sdavarzani/Haptic-Glove-Data-Acquisition/docs/Haptic_System_Schematic_page-0002.jpg

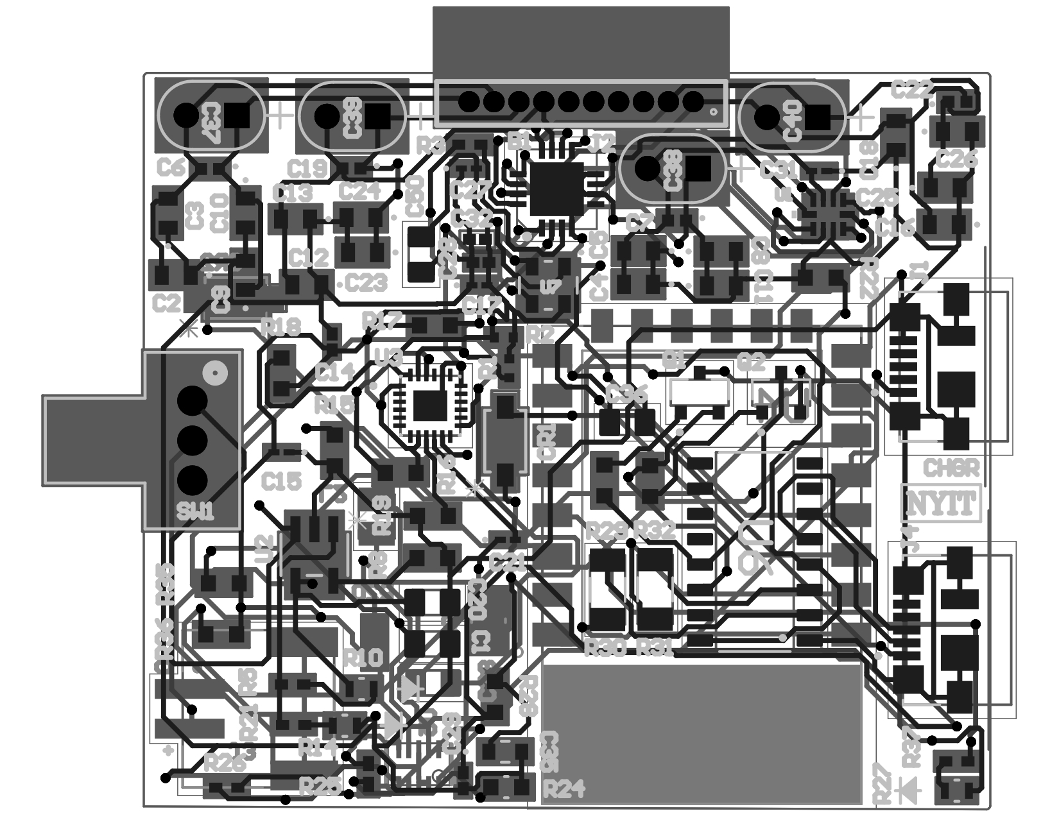
docs/Haptic_System_Schematic_page-0002.jpg
