sdavarzani/Haptic-Glove-Data-Acquisition/bom/BOM_V5.xlsx

Comment | Designator | Footprint | JLCPCB Part
Inductance-to-Digital Converter -4 Ch | B1 | WQFN-16_4x4x0.8P | C2667274
10 µF 10V Ceramic Capacitor 0805 | C1, C20, C33, C36, C50 | 0805_C | C1713
18 pF ±5% 6.3V Ceramic Capacitor | C2, C3, C4, C5, C8, C9, C10, C11, C12, C13, C16, C18, C23, C24, C25, C26 | 0603_C | C389109
33 pF ±10% 10V Ceramic Capacitor | C6, C7, C19, C22 | 0402_C | C2169710
10000 pF ±10% 10V Ceramic Capacitor | C14, C28 | 0402_C | C26569974
0.1 µF ±10% 6.3V Ceramic Capacitor | C15, C17, C21, C27, C31 | 0603_C | C76928
470 pF ±5% 50V Ceramic Capacitor | C29 | 0402_C | C2167469
100 µF ±20% 6.3V Ceramic Capacitor | C30 | 0805_C | C141660
1 µF ±10% 6.3V Ceramic Capacitor | C32 | 0402_C | C2649511
22 µF ±20% 10V Ceramic Capacitor | C35 | 0603_C | C86295
Diode 40 V 1A Surface Mount SOD-123 | CR1, CR2 | SOD-123 | C84354
Micro-USB-B | J1, J4 | MOLEX_47346-0001 | C132560
470 nH Shielded Multilayer Inductor 500 mA | L1 | 0806_L | C668312
(BJT) Transistor NPN 45 V 500 m | Q1, Q2 | SOT-23 | C39828
4.7 kOhms ±5% 0.063W, 1/16W | R1, R2 | 0402_R | C25900
RES 0 OHM JUMPER 1/16W 0402 | R3 | 0402_R | C60485
470 Ohms ±1% 0.063W, 1/16W Chip Resistor | R5, R21, R37 | 0402_R | C114877
RES 10 kOhms ±1% 0.1W, 1/10W | R8, R15, R16, R17, R18, R19, R20, R22, R28, R29, R32, R35, R36 | 0603_R | C98220
RedLED Indication - 2.2V 0603 | R10, R27 | 0603_LED | C2693608
GreenLED Indication 2.2V 0603 | R14 | 0603_LED | C7012325
91 kOhms ±5% 0.1W, 1/10W Resistor | R24 | 0603_R | C137603
511 kOhms ±1% 0.063W, 1/16W Chip Resistor | R25 | 0402_R | C64042
100 kOhms ±5% 0.1W, 1/10W Resistor | R26 | 0402_R | C413017
470 Ohms ±1% 0.25W, 1/4W Resistor 1206 | R30, R31 | 1206_R | C4502
(SPDT), 2-channel ,IC analog switch | U1 | UQFN-10 | C128409
Charger IC Lithium Ion/Polymer SOT-23-5 | U2 | SOT23-5 | C424093
ESP8266 | U4 | ESP-12E | C89297
Regulator IC Positive Adjustable | U5 | VSON-10 | C2845237
USB to serial chip CH340 | U6 | SOP-16 | C84681
40 MHz CMOS Oscillator | U7 | OSC-SMD_2.5x2.0 | C669071
