sdavarzani/Haptic-Glove-Data-Acquisition/docs/Haptic_System_Schematic.pdf

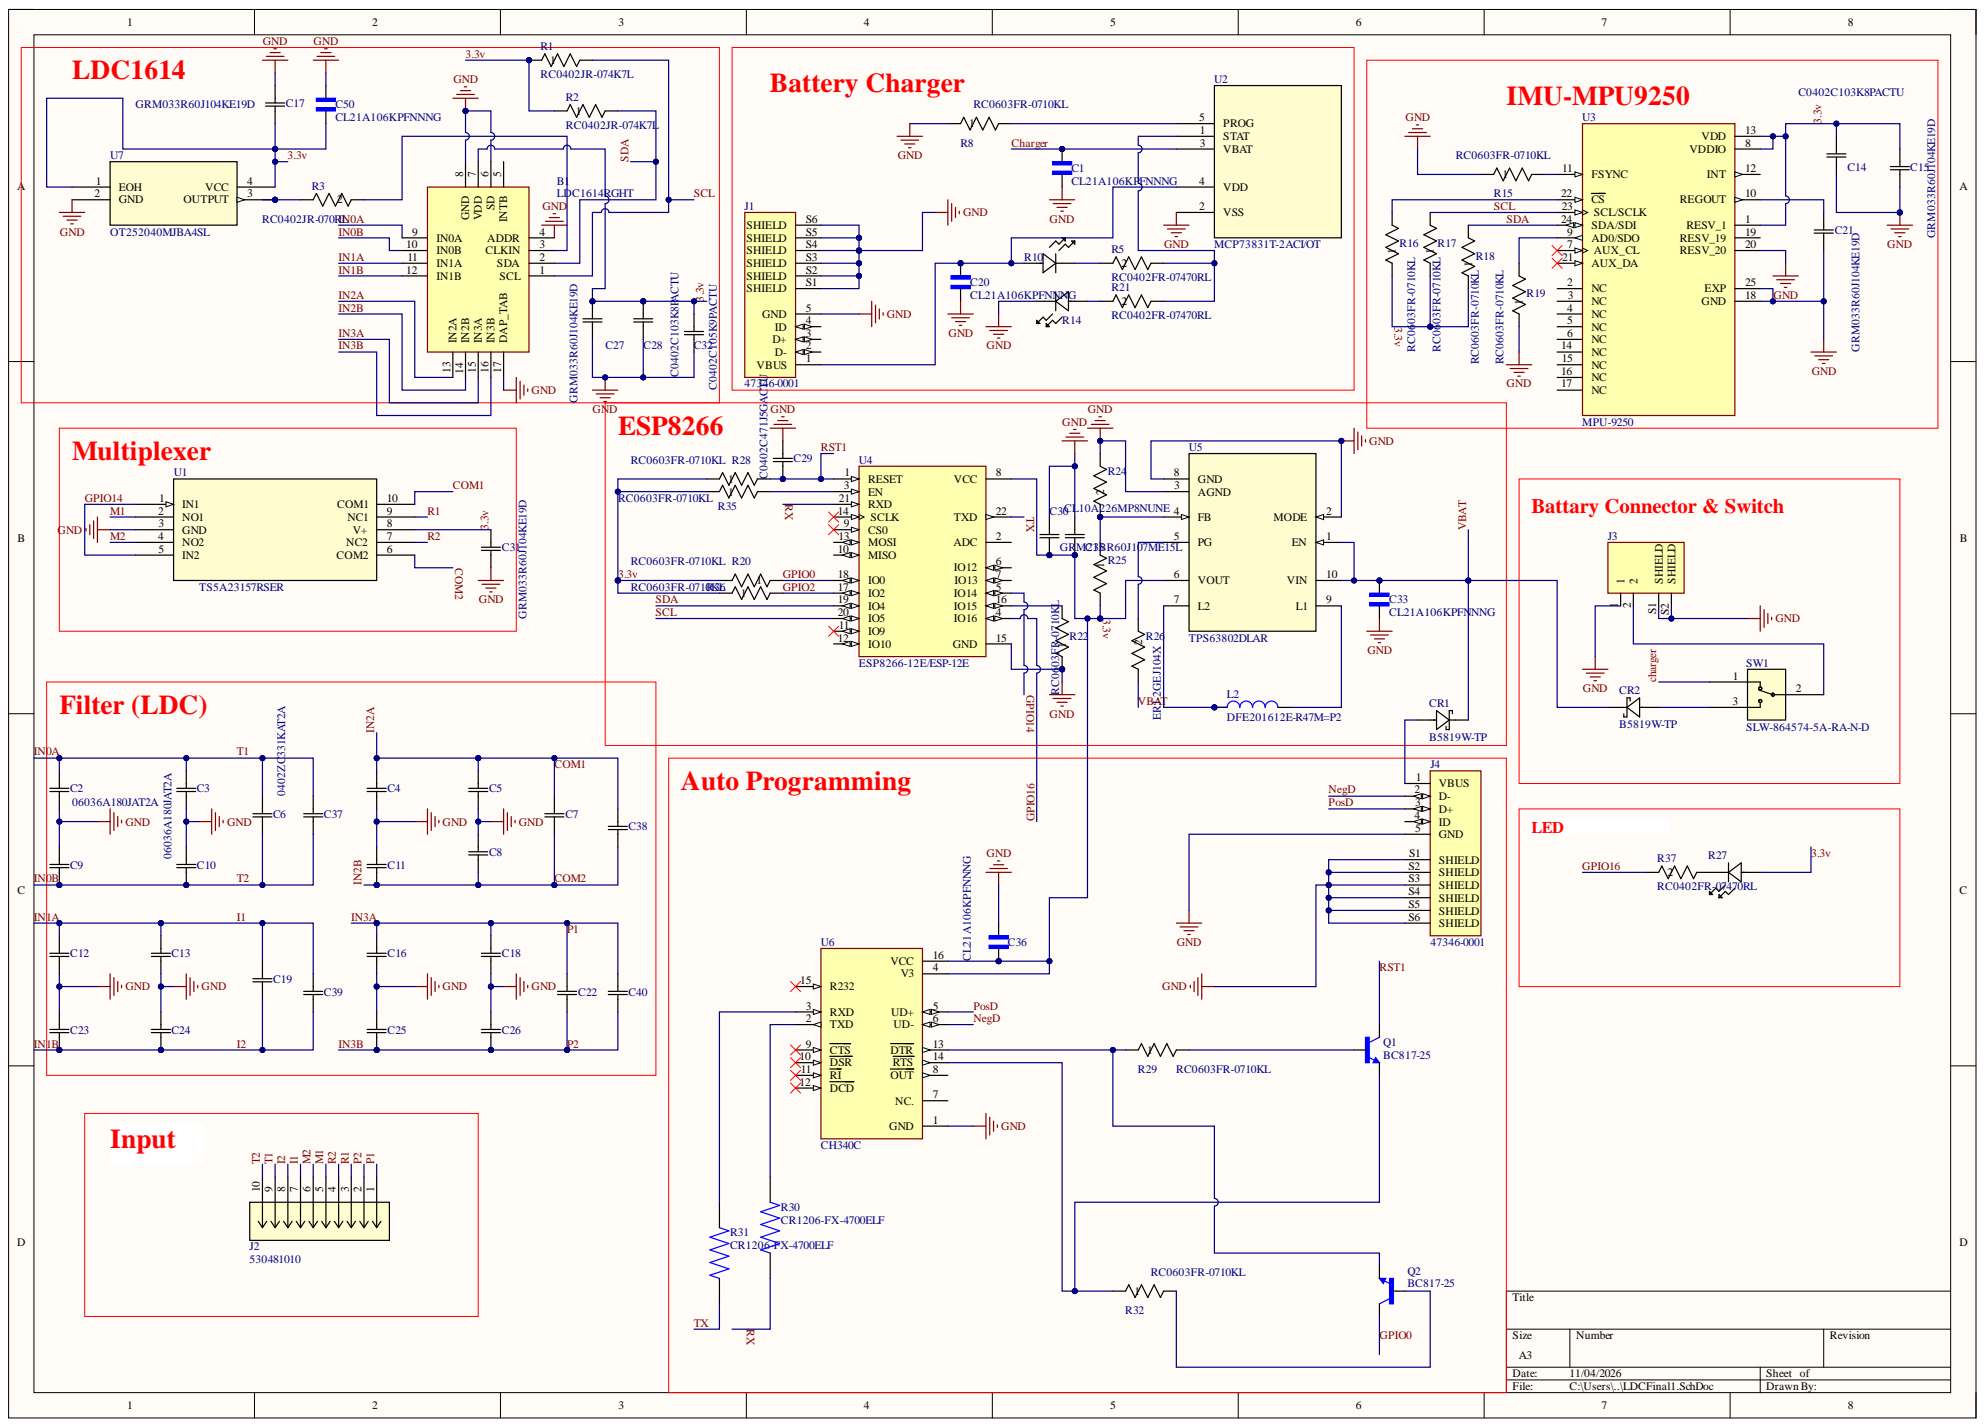
[picture p6: page 1]

INTB 5 SD 6 VDD 7 GND 8

SHIELD S3

SHIELD S5

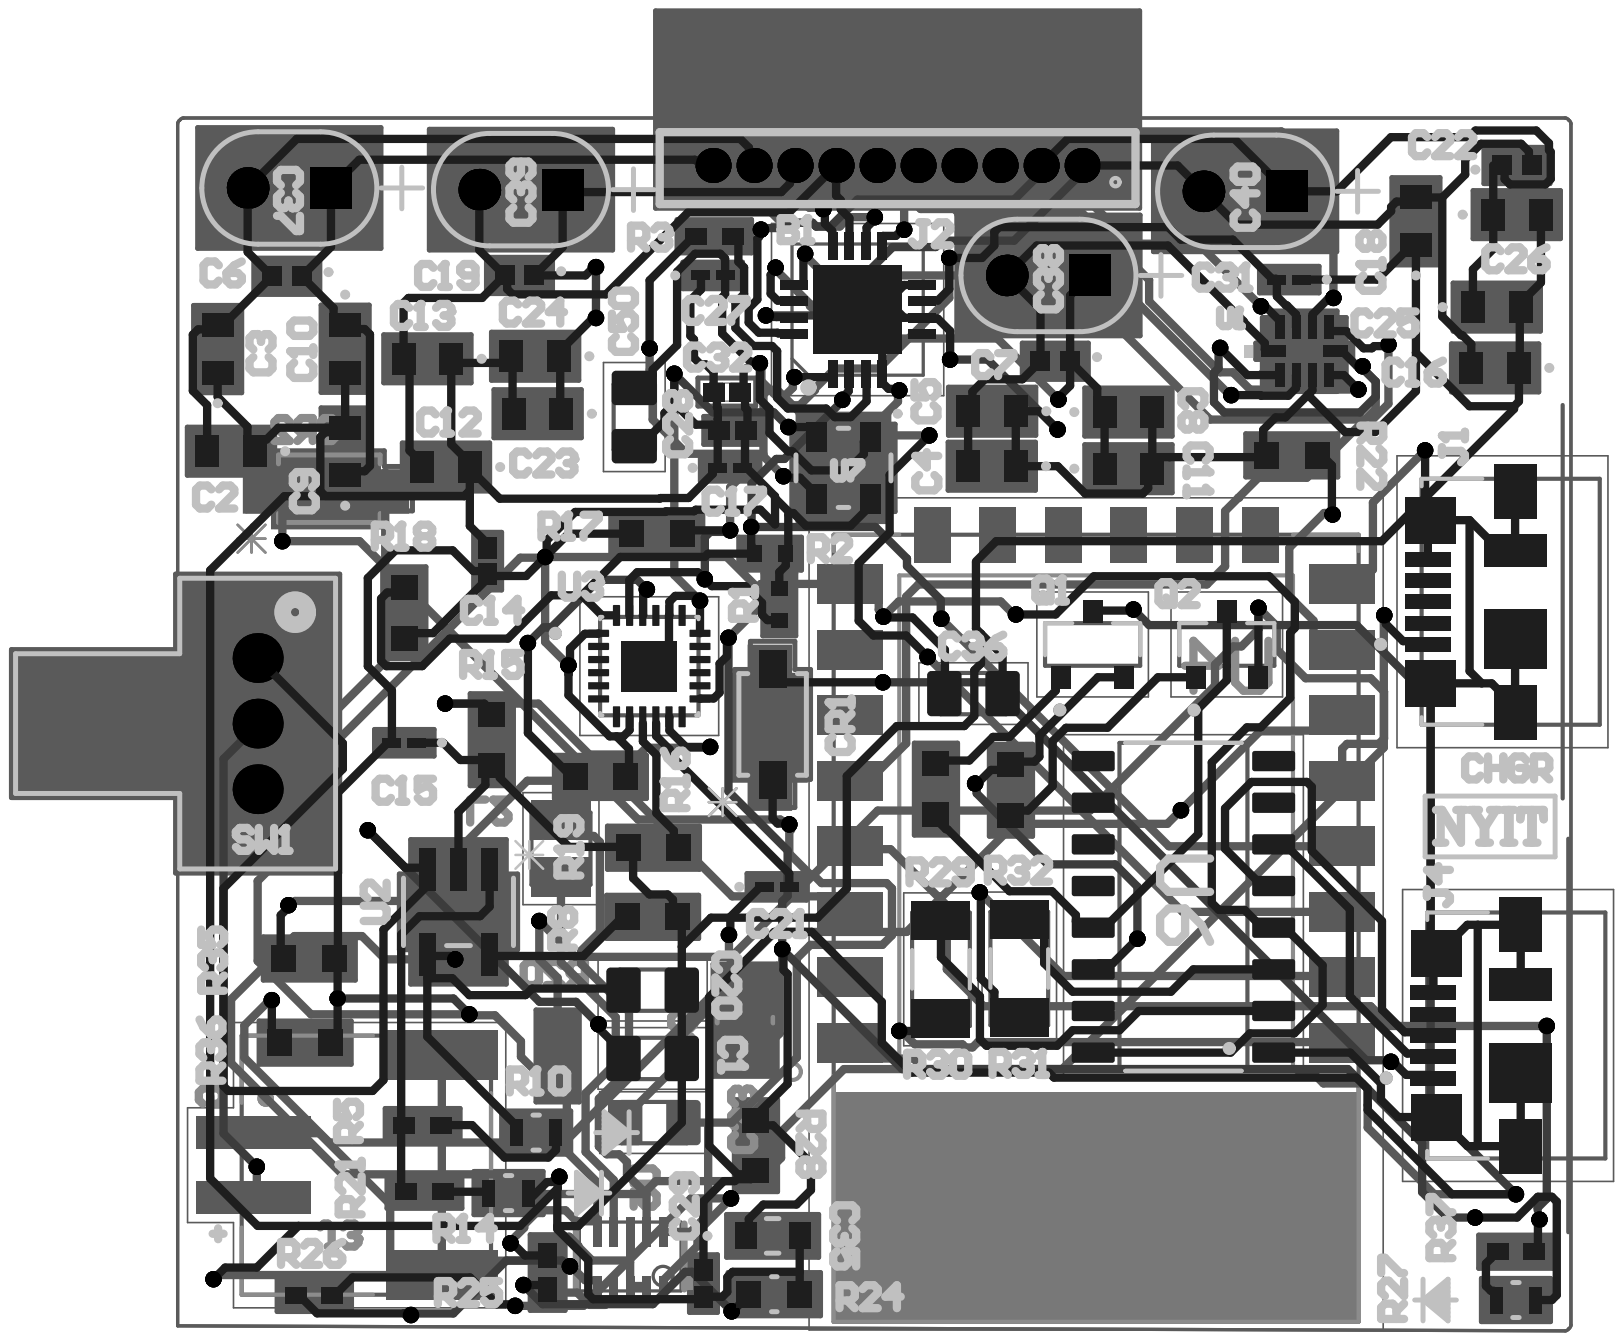
[picture p7: page 2]
