sdavarzani/Haptic-Glove-Data-Acquisition/(list of files, drawings)

Other design files:
hardware/LDC1.PrjPcb
hardware/LDC1.SCHLIB
hardware/LDCFinal1.SchDoc
hardware/LDCFullN.PcbDoc
hardware/LDCFullN.PcbLib
